bikerglen/one-tube-clock/boards/controller-board/rz568m-power-data-v2.brd

## EAGLE design boards/controller-board/rz568m-power-data-v2.brd (2020-06-04)

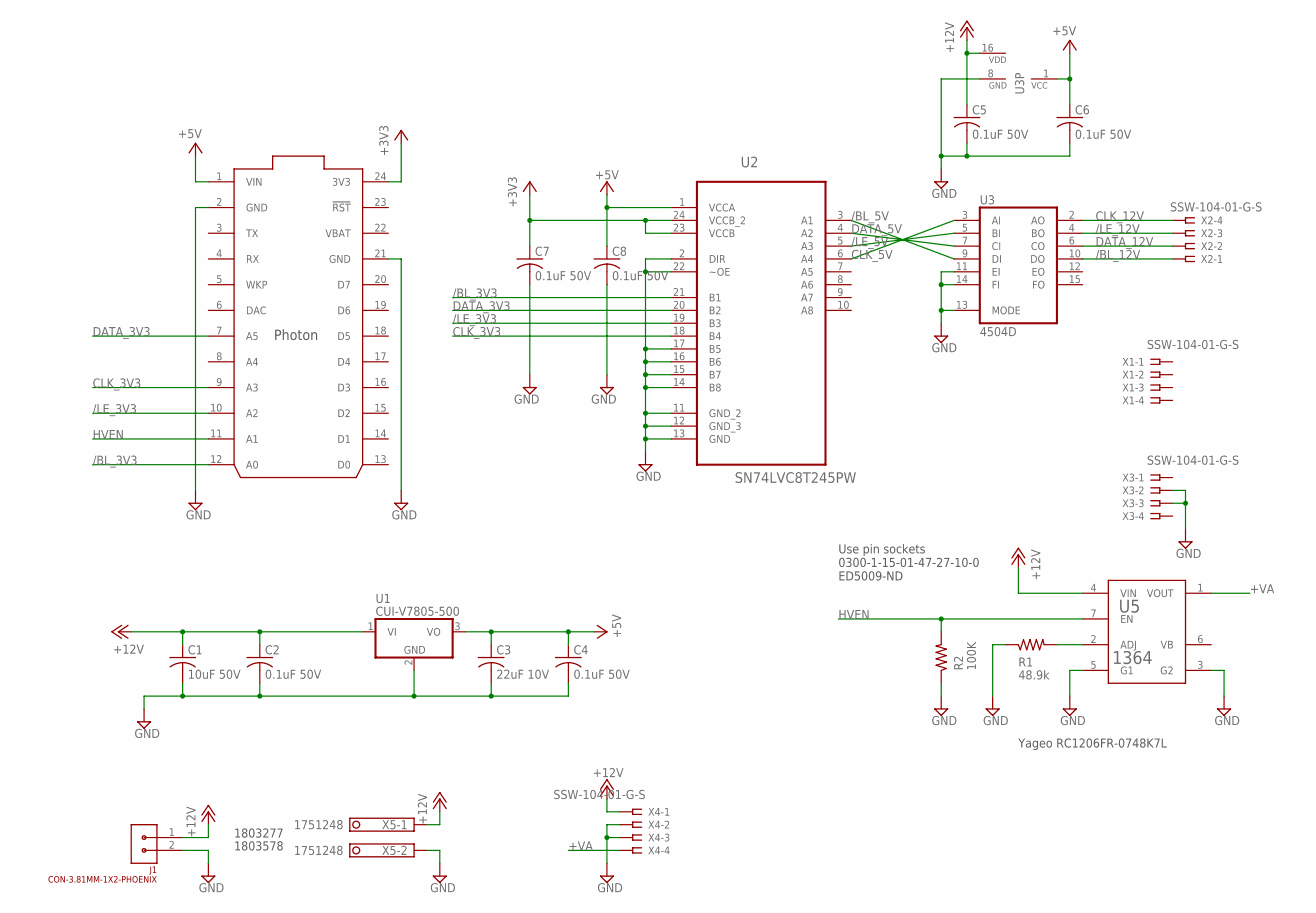
[picture p1: schematic rz568m-power-data-v2.sch]

Parts:
C1: 10uF 50V; C1210K; MFR_PART_NO C1210C106K5RACTU
C2, C4: 0.1uF 50V; C1206K; MFR_PART_NO C1206S104M5RACTU
C3: 22uF 10V; C1206K; MFR_PART_NO C1206C226K8RAC7800
C5, C6, C7, C8: 0.1uF 50V; C0805K; MFR_PART_NO C1206S104M5RACTU
J1: CON-3.81MM-1X2-PHOENIX; CON-PHOENIX-3.81-1X2-RA
R1: 48.9k; R1206
R2: 100K; R1206
U1: CUI-V7805-500; CUI-78XX-500
U2: SN74LVC8T245PW; SOP65P640X120-24N
U3: 4504D; SO16
U4: PHOTON_WITH_HEADERS; PHOTON
U5: 1364
X1, X2, X3, X4: SSW-104-01-G-S; SSW-104-02-S-S
X5: 1751248

Connections:
+3V3: C7.1, U2.23 (VCCB), U2.24 (VCCB_2), U4.24 (3V3)
+5V: C3.1, C4.1, C6.1, C8.1, U1.3 (VO), U2.1 (VCCA), U3.1 (VCC), U4.1 (VIN)
+12V: C1.1, C2.1, C5.1, J1.1, U1.1 (VI), U3.16 (VDD), U5.4 (VIN), X4.1, X5.1
+VA: U5.1 (VOUT), X4.4
/BL_3V3: U2.21 (B1), U4.12 (A0)
/BL_5V: U2.3 (A1), U3.9 (DI)
/BL_12V: U3.10 (DO), X2.1
/LE_3V3: U2.19 (B3), U4.10 (A2)
/LE_5V: U2.5 (A3), U3.5 (BI)
/LE_12V: U3.4 (BO), X2.3
CLK_3V3: U2.18 (B4), U4.9 (A3)
CLK_5V: U2.6 (A4), U3.3 (AI)
CLK_12V: U3.2 (AO), X2.4
DATA_3V3: U2.20 (B2), U4.7 (A5)
DATA_5V: U2.4 (A2), U3.7 (CI)
DATA_12V: U3.6 (CO), X2.2
GND: C1.2, C2.2, C3.2, C4.2, C5.2, C6.2, C7.2, C8.2, J1.2, R1.1, R2.1, U1.2 (GND), U2.2 (DIR), U2.11 (GND_2), U2.12 (GND_3), U2.13 (GND), U2.14 (B8), U2.15 (B7), U2.16 (B6), U2.17 (B5), U2.22 (~OE), U3.8 (GND), U3.11 (EI), U3.13 (MODE), U3.14 (FI), U4.2 (GND), U4.21 (GND), U5.3 (G2), U5.5 (G1), X3.2, X3.3, X4.2, X4.3, X5.2
HVEN: R2.2, U4.11 (A1), U5.7 (EN)
unnamed: R1.2, U5.2 (ADJ)
VBAT: U4.22 (VBAT)

Notes on the sheet:
Yageo RC1206FR-0748K7L
1803277
1803578
Use pin sockets 0300-1-15-01-47-27-10-0 ED5009-ND

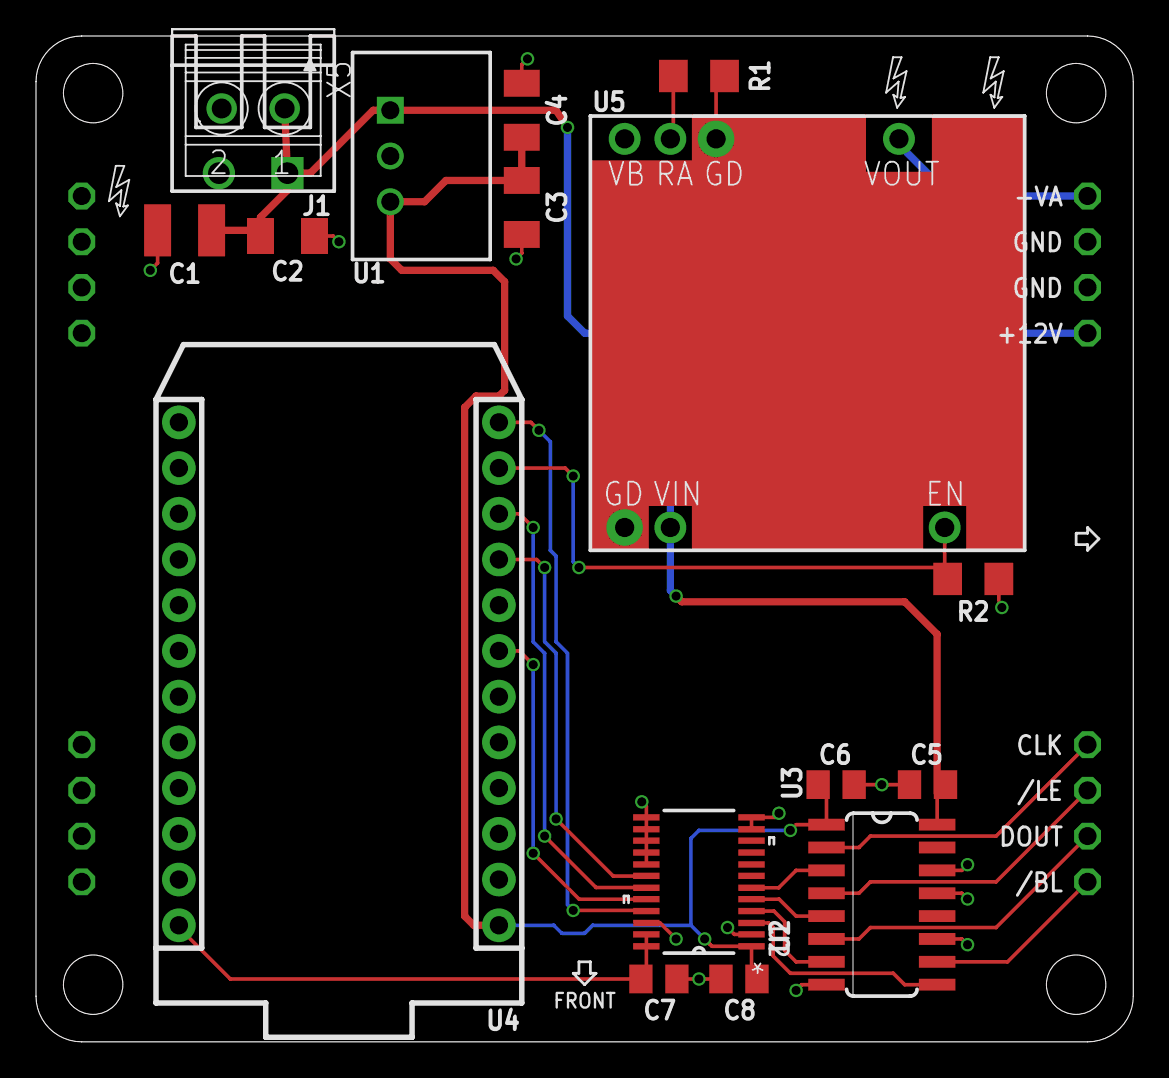
[picture p2: board rz568m-power-data-v2.brd from above]

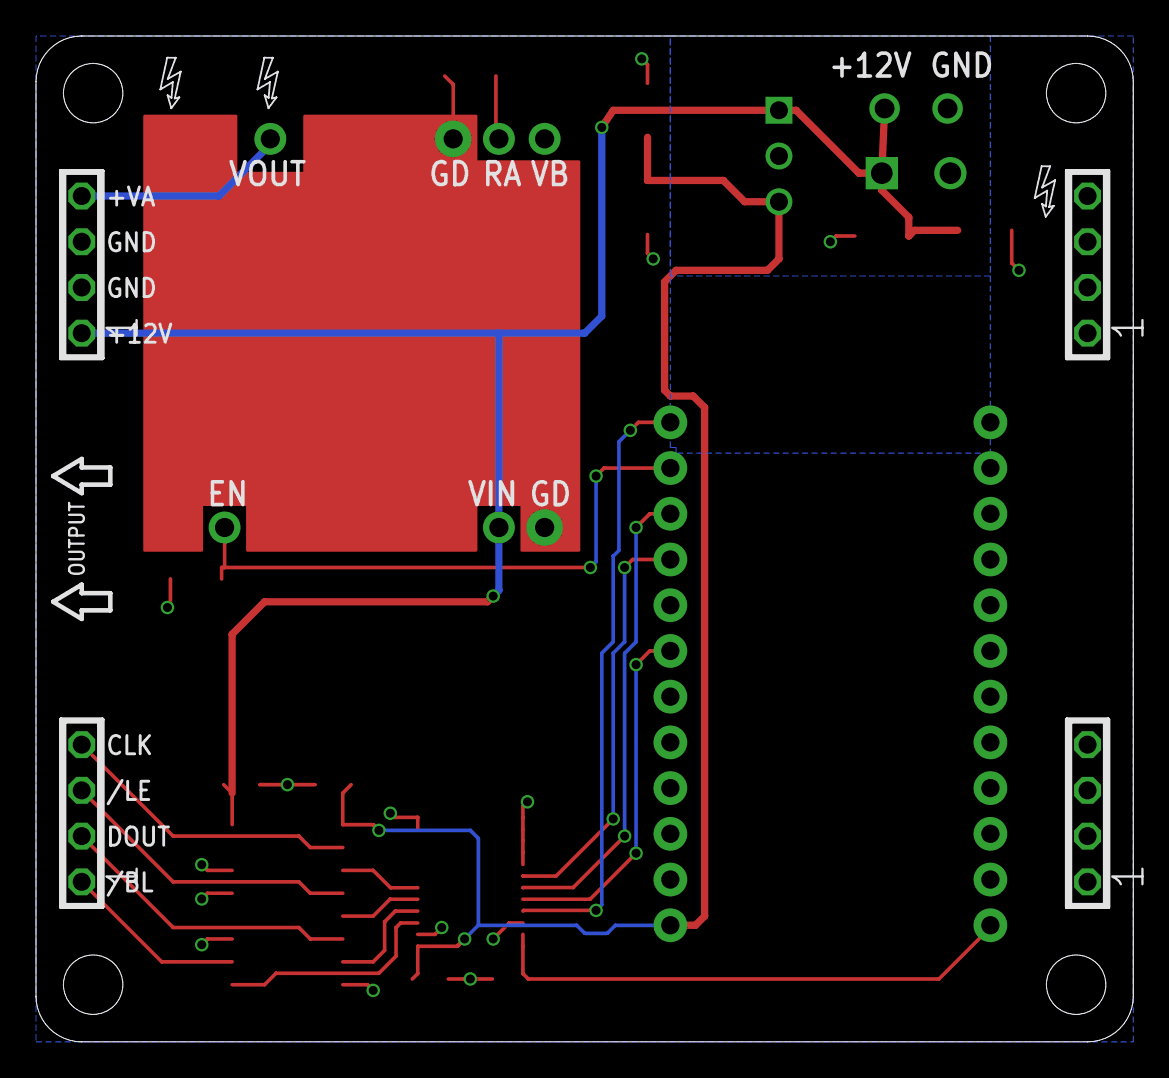
[picture p3: board rz568m-power-data-v2.brd from below]

Board: 2 copper layers, 61.0 x 55.9 mm, 21 parts (4 on the bottom side), 19 nets.
