bikerglen/one-tube-clock/boards/socket-board/rz568m-test-v1.brd

## EAGLE design boards/socket-board/rz568m-test-v1.brd (2020-06-04)

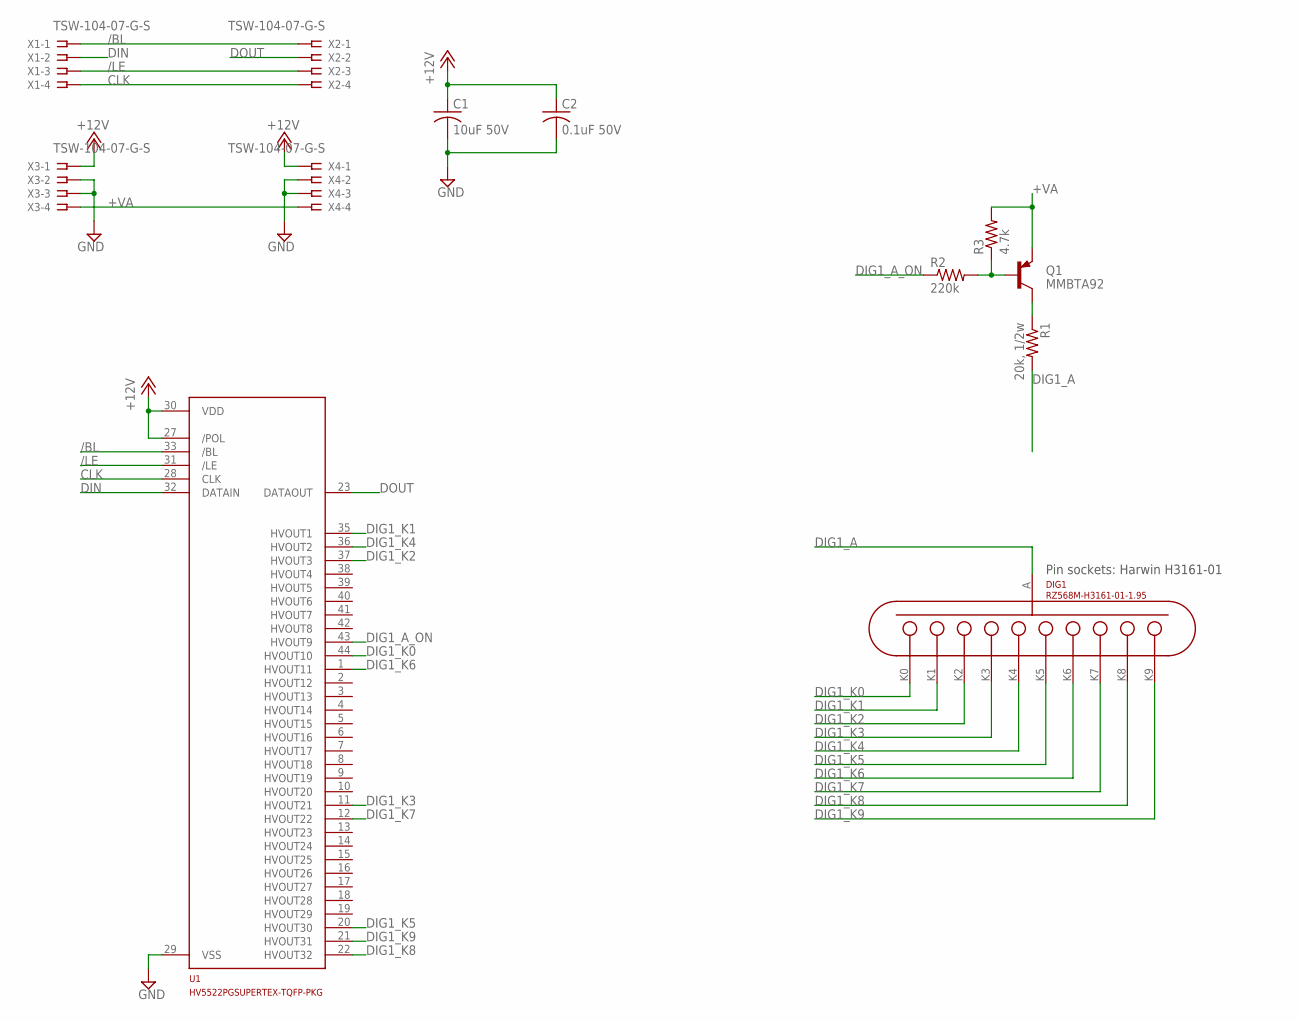
[picture p4: schematic rz568m-test-v1.sch]

Parts:
C1: 10uF 50V; C1210K; MFR_PART_NO C1210C106K5RACTU
C2: 0.1uF 50V; C1206K; MFR_PART_NO C1206S104M5RACTU
DIG1: RZ568M-H3161-01-1.95; MFR_PART_NO H3161-01
Q1: MMBTA92; SOT23-BEC; MFR_PART_NO MMBTA92
R1: 20k, 1/2w; R1210; MFR_PART_NO ERJ-14NF2002U
R2: 220k; R1206; MFR_PART_NO ERJ-8GEYJ224V
R3: 4.7k; R1206; MFR_PART_NO ERJ-8ENF4701V
U1: HV5522PGSUPERTEX-TQFP-PKG; TQFP44-HV5522PG; MFR_PART_NO HV5522PG
X1, X2, X3, X4: TSW-104-07-G-S; SSW-104-02-S-S; MFR_PART_NO TSW-104-07-G-S

Connections:
+12V: C1.1, C2.1, U1.27 (/POL), U1.30 (VDD), X3.1, X4.1
+VA: Q1.E, R3.2, X3.4, X4.4
/BL: U1.33 (/BL), X1.1, X2.1
/LE: U1.31 (/LE), X1.3, X2.3
CLK: U1.28 (CLK), X1.4, X2.4
DIG1_A: DIG1.A, R1.2
DIG1_A_ON: R2.1, U1.43 (HVOUT9)
DIG1_BASE: Q1.B, R2.2, R3.1
DIG1_COLLECTOR: Q1.C, R1.1
DIG1_K0: DIG1.K0, U1.44 (HVOUT10)
DIG1_K1: DIG1.K1, U1.35 (HVOUT1)
DIG1_K2: DIG1.K2, U1.37 (HVOUT3)
DIG1_K3: DIG1.K3, U1.11 (HVOUT21)
DIG1_K4: DIG1.K4, U1.36 (HVOUT2)
DIG1_K5: DIG1.K5, U1.20 (HVOUT30)
DIG1_K6: DIG1.K6, U1.1 (HVOUT11)
DIG1_K7: DIG1.K7, U1.12 (HVOUT22)
DIG1_K8: DIG1.K8, U1.22 (HVOUT32)
DIG1_K9: DIG1.K9, U1.21 (HVOUT31)
DIN: U1.32 (DATAIN), X1.2
DOUT: U1.23 (DATAOUT), X2.2
GND: C1.2, C2.2, U1.29 (VSS), X3.2, X3.3, X4.2, X4.3

Notes on the sheet:
Pin sockets: Harwin H3161-01

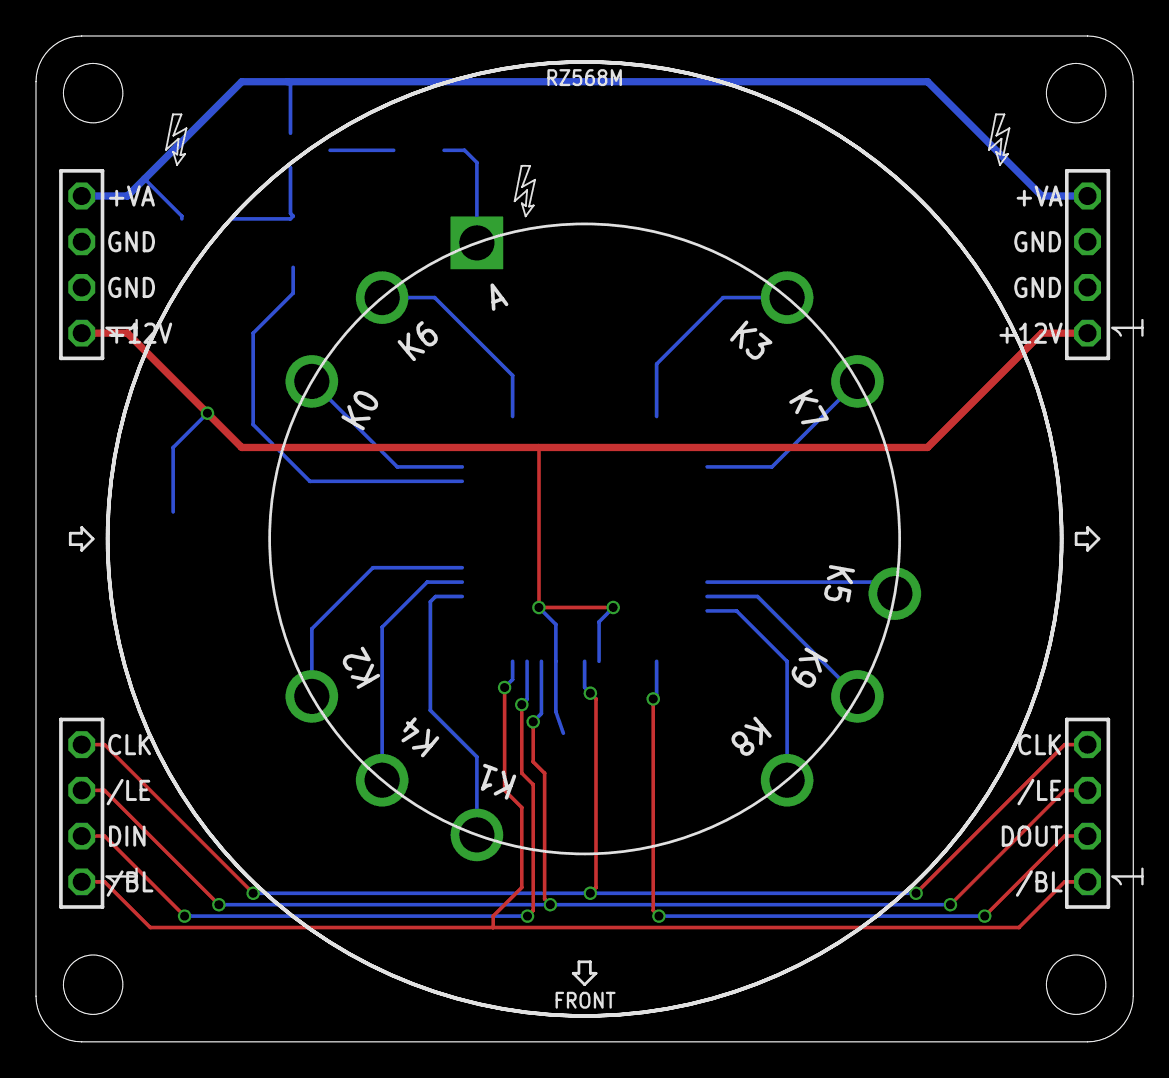
[picture p5: board rz568m-test-v1.brd from above]

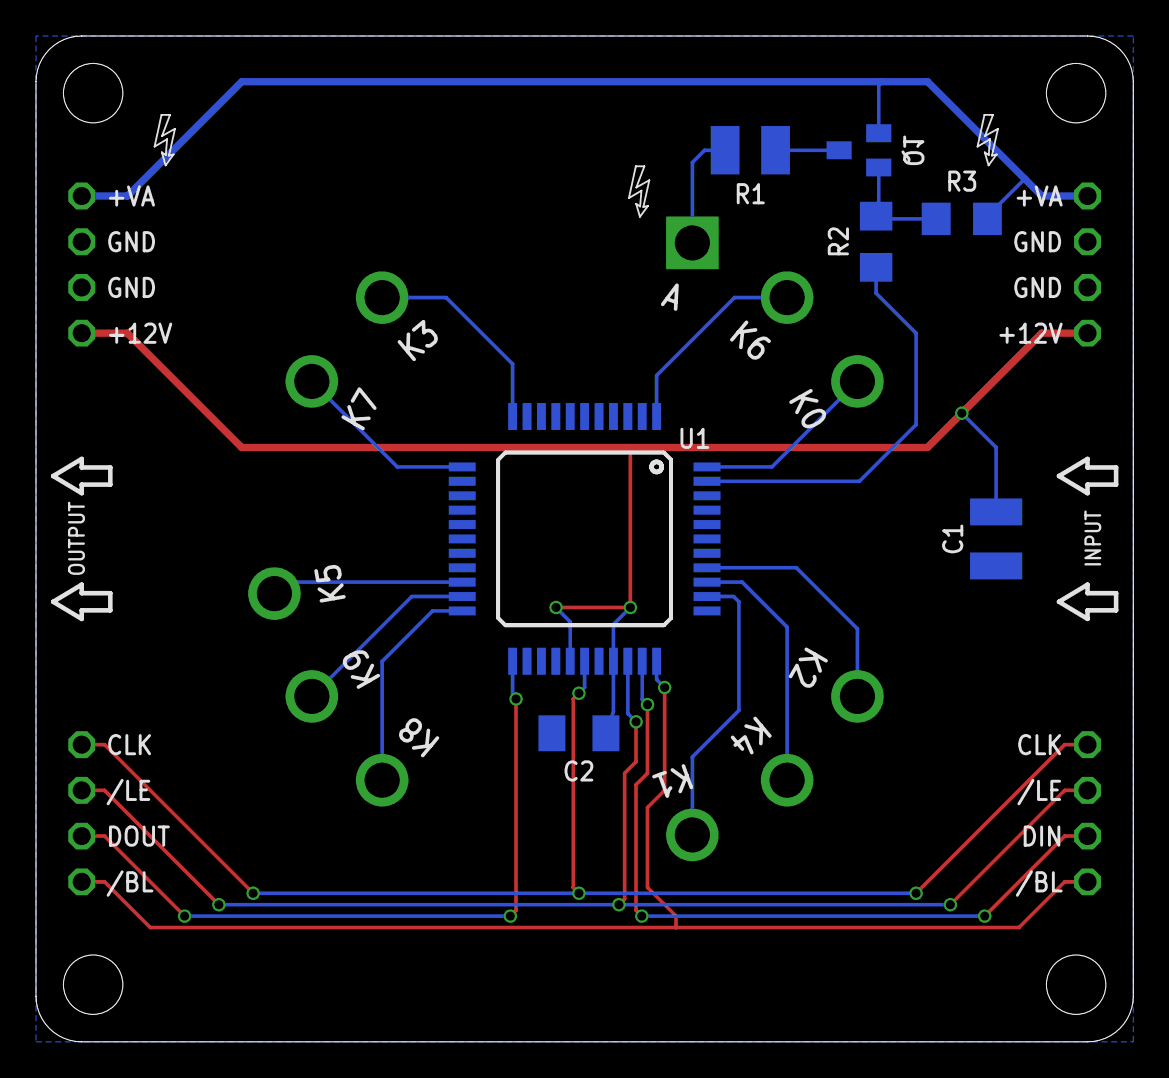
[picture p6: board rz568m-test-v1.brd from below]

Board: 2 copper layers, 61.0 x 55.9 mm, 12 parts (7 on the bottom side), 22 nets.
